andrewesterhuizen/ATS/hardware/ATS BOM.xlsx

QTY | Part | Value | Device | Package
2 | C1,C2 | 10n | C-USC0603 | C0603 | https://www.mouser.co.uk/ProductDetail/KEMET/C0603C103J5RACAUTO
5 | C3,C15,C6,C7,C8 | 100n | C-USC0603 | C0603 | https://www.mouser.co.uk/ProductDetail/80-C0603C104J3RAUTO
1 | C12 | 470n | C-USC0603 | C0603 | https://www.mouser.co.uk/ProductDetail/80-C0603C474Z4VACTU
2 | C13,C14 | 18p | C-USC0603 | C0603 | https://www.mouser.co.uk/ProductDetail/80-C0603X180J5GAUTO
2 | C4,C5 | 22u | CPOL-USC | PANASONIC_C | https://www.mouser.co.uk/ProductDetail/Panasonic/EEE-FP1E220AR?qs=d1CqaRUMZD%252ByxlCLn0gmaw%3D%3D
5 | R12,R13,R14,R15,R16 | 180R | R-US_R0603 | R0603 | https://www.mouser.co.uk/ProductDetail/Panasonic/ERJ-3EKF1800V?qs=iBwFsHVUAOdnbRARlthUug%3D%3D
5 | R17,R18,R19,R20,R21 | 1.0k | R-US_R0603 | R0603 | https://www.mouser.co.uk/ProductDetail/Panasonic/ERJ-3EKF1001V?qs=H7k1u0Mp9JTM8yQxOuvoDg%3D%3D
1 | R1,R22 | 10k | R-US_R0603 | R0603 | https://www.mouser.co.uk/ProductDetail/Panasonic/ERJ-3EKF1002V?qs=H7k1u0Mp9JSrGPQ5%2F5COuw%3D%3D
11 | R2,R4,R5,R6,R7,R8,R9,R10,R11,R23 | 100k | R-US_R0603 | R0603 | https://www.mouser.co.uk/ProductDetail/Panasonic/ERJ-3EKF1003V?qs=H7k1u0Mp9JSqh2R2gj46DA==
1 | R3 | 1M | R-US_R0603 | R0603 | https://www.mouser.co.uk/ProductDetail/Panasonic/ERJ-3EKF1004V?qs=6%252BUraArZVSCwybhfQn7iYg==
1 | D6 | 1N5819HW | DIODE-SOD123 | SOD123 | https://www.mouser.co.uk/ProductDetail/Diodes-Incorporated/1N5819HW-7-F?qs=NQ47qNm99eDyWTEd07miYA%3D%3D
1 | L1 | 470Ohm@100MHz | WE-CBF_0603_742792642_WB_HS | WE-CBF_0603(W=2.2) | https://www.mouser.co.uk/ProductDetail/Wurth-Elektronik/742792642?qs=5twSNpOB8ID4fgXFKV3JbA%3D%3D
1 | T1 | MMBT3904 | MMBT3904LT1-NPN-SOT23-BEC | SOT23-BEC | https://www.mouser.co.uk/ProductDetail/ON-Semiconductor/MMBT3904LT1G?qs=HVbQlW5zcXUYZ2Fy0YF3FQ%3D%3D
1 | Q1 | Quartz, 20 MHz | CRYSTALHC49UP (CRYSTAL) (Version 2) | HC49 | https://www.mouser.co.uk/ProductDetail/ABRACON/ABLS2-20000MHZ-D4Y-T?qs=LoTOQoUkC8SXA4t9TL%252BOxw==
1 | IC1 | LM4040 5.0V | LM4041C12DBZ | DBZ_R-PDSO-G3 | https://www.mouser.co.uk/ProductDetail/Texas-Instruments/LM4040C50IDBZR?qs=paYhMW8qfit8YlA5meG8ww%3D%3D
1 | IC2 | LM1117-5.0 | REG1117 | SOT223 | https://www.mouser.co.uk/ProductDetail/Texas-Instruments/LM1117MPX-50-NOPB?qs=X1J7HmVL2ZE1O12Qsl7F9g==
1 | IC3 | MCP6002_ | MCP6002_ | SO08 | https://www.mouser.co.uk/ProductDetail/Microchip-Technology/MCP6002-I-SN?qs=cQYLKLPzRJlt69SDaZwGcA%3D%3D
1 | IC4 | ATMEGA328P_TQFP | ATMEGA328P_TQFP | TQFP32-08 | https://www.mouser.co.uk/ProductDetail/Microchip-Technology-Atmel/ATMEGA328P-AU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
8 | J1,J2,J3,J4,J5,J6,J7,J8 | THONKICONNNEW | THONKICONNNEW | WQP-PJ301M-12_JACK | https://www.thonk.co.uk/shop/thonkiconn/
2 | R24,R25 | 10k | 9MM_SNAP-IN_POT_ | 9MM_SNAP-IN_POT | https://www.thonk.co.uk/shop/alpha-9mm-pots-dshaft/
5 | LED1,LED2,LED3,LED4,LED5 | WP710A10ID | LED3MM | LED_3MM | https://www.mouser.co.uk/ProductDetail/604-WP710A10ID
1 | J9 | AVR_SPI_PRG_6PTH | AVR_SPI_PRG_6PTH | 2X3
1 | JP1 | EURO_POWER_HEADERREGULAR | EURO_POWER_HEADERREGULAR | EURO_POWER_HEADER
1 | S1 | TL1105SPF250Q | TAC_SWITCHPTH | TACTILE-PTH | https://www.mouser.co.uk/ProductDetail/E-Switch/TL1105SPF250Q | https://www.mouser.co.uk/ProductDetail/E-Switch/TL1105SPF100Q?qs=xDsBkp9LkocnccFHlWJUlg%3D%3D
1 | S1 cap |  |  |  | https://www.mouser.co.uk/ProductDetail/E-Switch/1RBLK?qs=3Jlm%2Fl9ddLwhWMMiZ2NaSQ%3D%3D
