andrewesterhuizen/ATS/hardware/ATS.brd

## EAGLE design hardware/ATS.brd (2020-06-15)

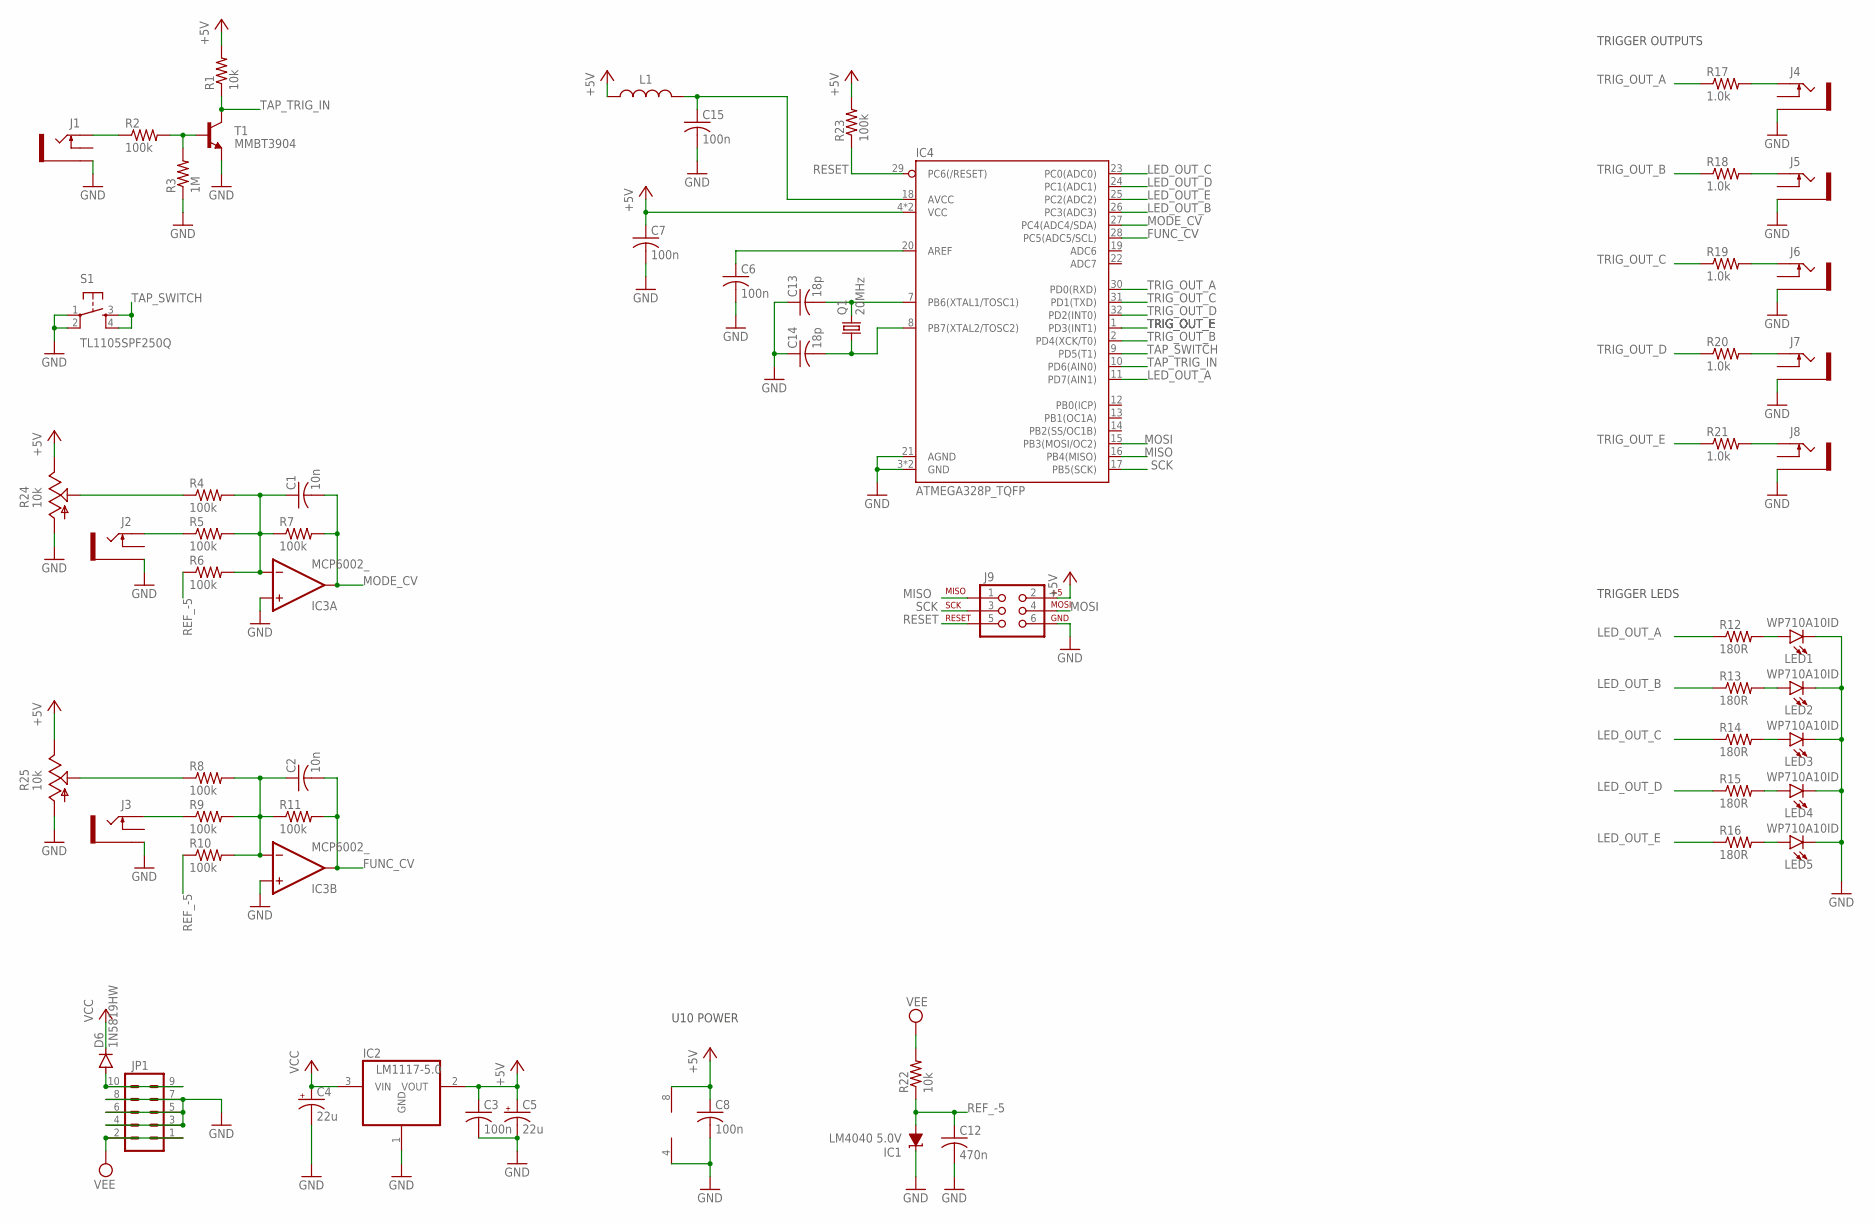
[picture p1: schematic ATS.sch]

Parts:
C1, C2: 10n; C0603
C3, C6, C7, C8, C15: 100n; C0603
C4, C5: 22u; PANASONIC_C
C12: 470n; C0603
C13, C14: 18p; C0603
D6: 1N5819HW; SOD123
IC1: LM4040 5.0V; DBZ_R-PDSO-G3
IC2: LM1117-5.0; SOT223
IC3: MCP6002_; SO08
IC4: ATMEGA328P_TQFP; TQFP32-08
J1, J2, J3, J4, J5, J6, J7, J8: THONKICONNNEW; WQP-PJ301M-12_JACK
J9: AVR_SPI_PRG_6PTH; 2X3
JP1: EURO_POWER_HEADERREGULAR; EURO_POWER_HEADER
L1: 470Ohm@100MHz; WE-CBF_0603(W=2.2)
LED1, LED2, LED3, LED4, LED5: WP710A10ID; LED_3MM
Q1: 20MHz; HC49UP
R1, R22: 10k; R0603
R2, R4, R5, R6, R7, R8, R9, R10, R11, R23: 100k; R0603
R3: 1M; R0603
R12, R13, R14, R15, R16: 180R; R0603
R17, R18, R19, R20, R21: 1.0k; R0603
R24, R25: 10k; 9MM_SNAP-IN_POT
S1: TL1105SPF250Q; TACTILE-PTH
T1: MMBT3904; SOT23-BEC

Connections:
+5V: C3.1, C5.+, C7.1, C8.1, IC2.2 (VOUT), IC3.8 (V+), IC4.4 (VCC), IC4.6 (VCC), J9.2, L1.1, R1.2, R23.2, R24.3 (E), R25.3 (E)
AREF: C6.1, IC4.20 (AREF)
FUNC_CV: C2.2, IC3.7 (OUT), IC4.28 (PC5(ADC5/SCL)), R11.2
FUNC_JACK: J3.P$1_TIP (TIP), R9.1
FUNC_POT: R8.1, R25.2 (S)
GND: C3.2, C4.-, C5.-, C6.2, C7.2, C8.2, C12.2, C13.1, C14.1, C15.2, IC1.1 (C), IC2.1 (GND), IC3.3 (+IN), IC3.4 (V-), IC3.5 (+IN), IC4.3 (GND), IC4.5 (GND), IC4.21 (AGND), J1.P$3_SLEEVE (SLEEVE), J2.P$3_SLEEVE (SLEEVE), J3.P$3_SLEEVE (SLEEVE), J4.P$3_SLEEVE (SLEEVE), J5.P$3_SLEEVE (SLEEVE), J6.P$3_SLEEVE (SLEEVE), J7.P$3_SLEEVE (SLEEVE), J8.P$3_SLEEVE (SLEEVE), J9.6, JP1.3, JP1.4, JP1.5, JP1.6, JP1.7, JP1.8, LED1.K (C), LED2.K (C), LED3.K (C), LED4.K (C), LED5.K (C), R3.1, R24.1 (A), R25.1 (A), S1.1, S1.2, T1.E
LED_OUT_A: IC4.11 (PD7(AIN1)), R12.1
LED_OUT_B: IC4.26 (PC3(ADC3)), R13.1
LED_OUT_C: IC4.23 (PC0(ADC0)), R14.1
LED_OUT_D: IC4.24 (PC1(ADC1)), R15.1
LED_OUT_E: IC4.25 (PC2(ADC2)), R16.1
MISO: IC4.16 (PB4(MISO)), J9.1
MODE_CV: C1.2, IC3.1 (OUT), IC4.27 (PC4(ADC4/SDA)), R7.2
MODE_JACK: J2.P$1_TIP (TIP), R5.1
MODE_POT: R4.1, R24.2 (S)
MOSI: IC4.15 (PB3(MOSI/OC2)), J9.4
unnamed: LED1.A, R12.2
unnamed: C1.1, IC3.2 (-IN), R4.2, R5.2, R6.2, R7.1
unnamed: C2.1, IC3.6 (-IN), R8.2, R9.2, R10.2, R11.1
unnamed: LED2.A, R13.2
unnamed: LED3.A, R14.2
unnamed: R2.2, R3.2, T1.B
unnamed: J1.P$1_TIP (TIP), R2.1
unnamed: LED4.A, R15.2
unnamed: LED5.A, R16.2
unnamed: J4.P$1_TIP (TIP), R17.2
unnamed: J5.P$1_TIP (TIP), R18.2
unnamed: J6.P$1_TIP (TIP), R19.2
unnamed: J7.P$1_TIP (TIP), R20.2
unnamed: J8.P$1_TIP (TIP), R21.2
unnamed: C14.2, IC4.8 (PB7(XTAL2/TOSC2)), Q1.1
unnamed: C13.2, IC4.7 (PB6(XTAL1/TOSC1)), Q1.2
unnamed: C15.1, IC4.18 (AVCC), L1.2
unnamed: D6.A, JP1.9, JP1.10
REF_-5: C12.1, IC1.2 (A), R6.1, R10.1, R22.1
RESET: IC4.29 (PC6(/RESET)), J9.5, R23.1
SCK: IC4.17 (PB5(SCK)), J9.3
TAP_SWITCH: IC4.9 (PD5(T1)), S1.3, S1.4
TAP_TRIG_IN: IC4.10 (PD6(AIN0)), R1.1, T1.C
TRIG_OUT_A: IC4.30 (PD0(RXD)), R17.1
TRIG_OUT_B: IC4.2 (PD4(XCK/T0)), R18.1
TRIG_OUT_C: IC4.31 (PD1(TXD)), R19.1
TRIG_OUT_D: IC4.32 (PD2(INT0)), R20.1
TRIG_OUT_E: IC4.1 (PD3(INT1)), R21.1
VCC: C4.+, D6.C, IC2.3 (VIN)
VEE: JP1.1, JP1.2, R22.2

Notes on the sheet:
U10 POWER
TRIGGER OUTPUTS
TRIGGER LEDS

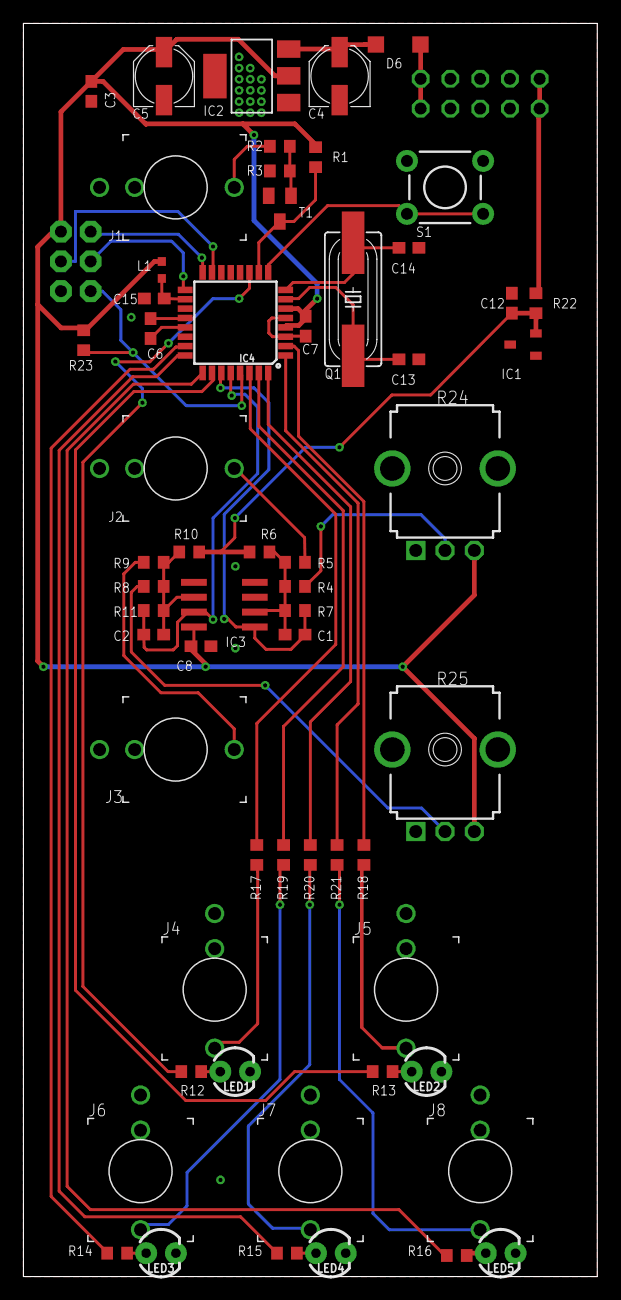
[picture p2: board ATS.brd from above]

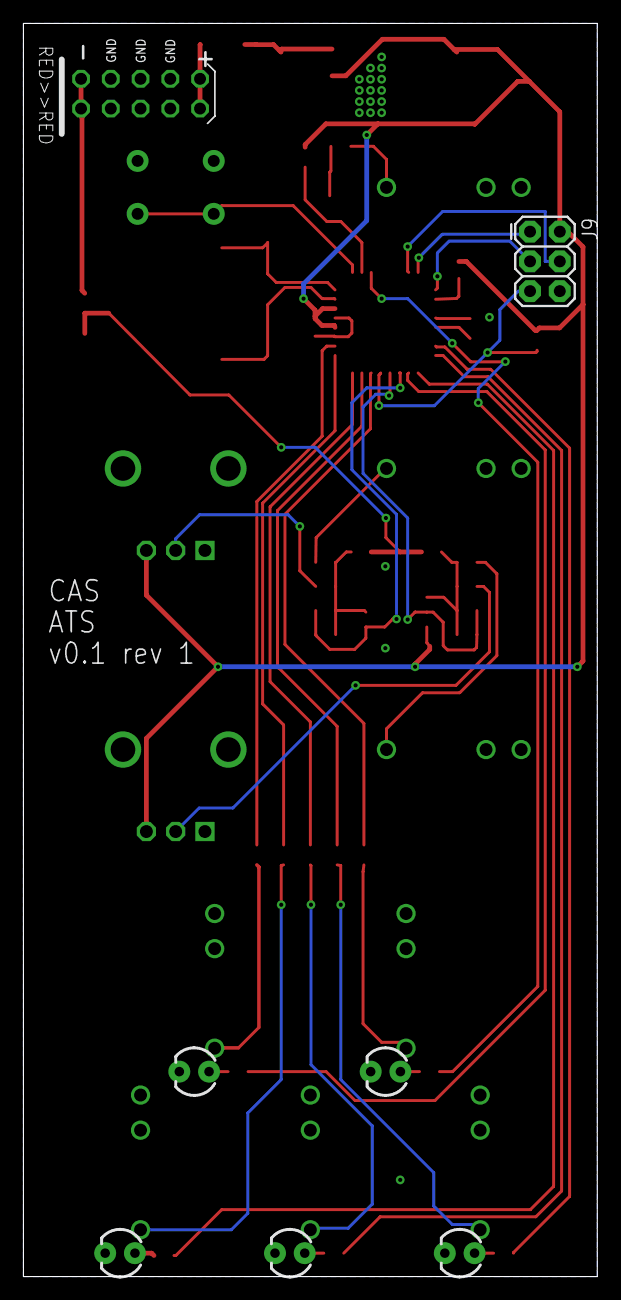
[picture p3: board ATS.brd from below]

Board: 2 copper layers, 49.0 x 107.0 mm, 61 parts (2 on the bottom side), 46 nets.
