andrewesterhuizen/ATS/(commit log)

2020-06-14 ATS init
    [ATS BOM.xlsx, ATS.brd, ATS.sch]
2020-06-15 ATS rev1
    [ATS BOM.xlsx, ATS.brd, ATS.sch]
2021-09-08 Simplify folder structure
    [ATS BOM.xlsx, ATS.brd, ATS.sch]
2021-09-08 Fix casing and make header guards consistent
    [ATS.cpp, adc8.h, debouncer.h, module.h, output_handler.h]
